xmyoot/custom-round-pcb-led-flash/client_request/IMG_7281.PNG

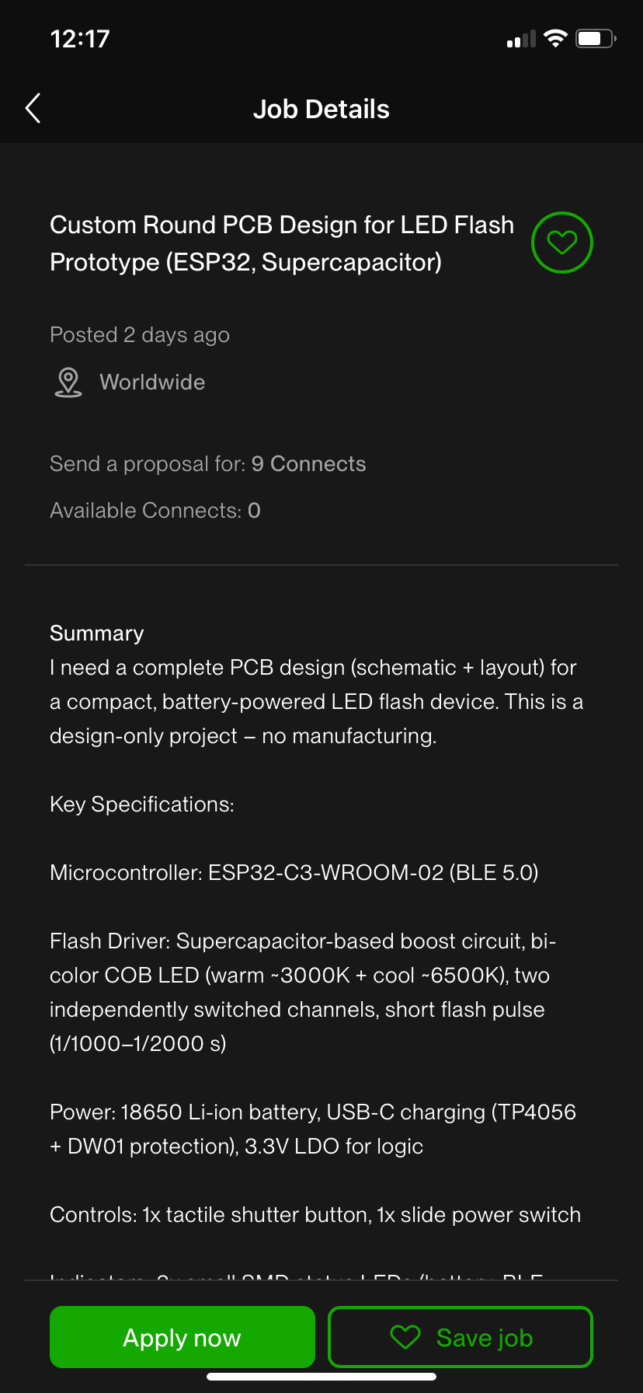
client_request/IMG_7281.PNG
