xmyoot/custom-round-pcb-led-flash/client_request/IMG_7282.PNG

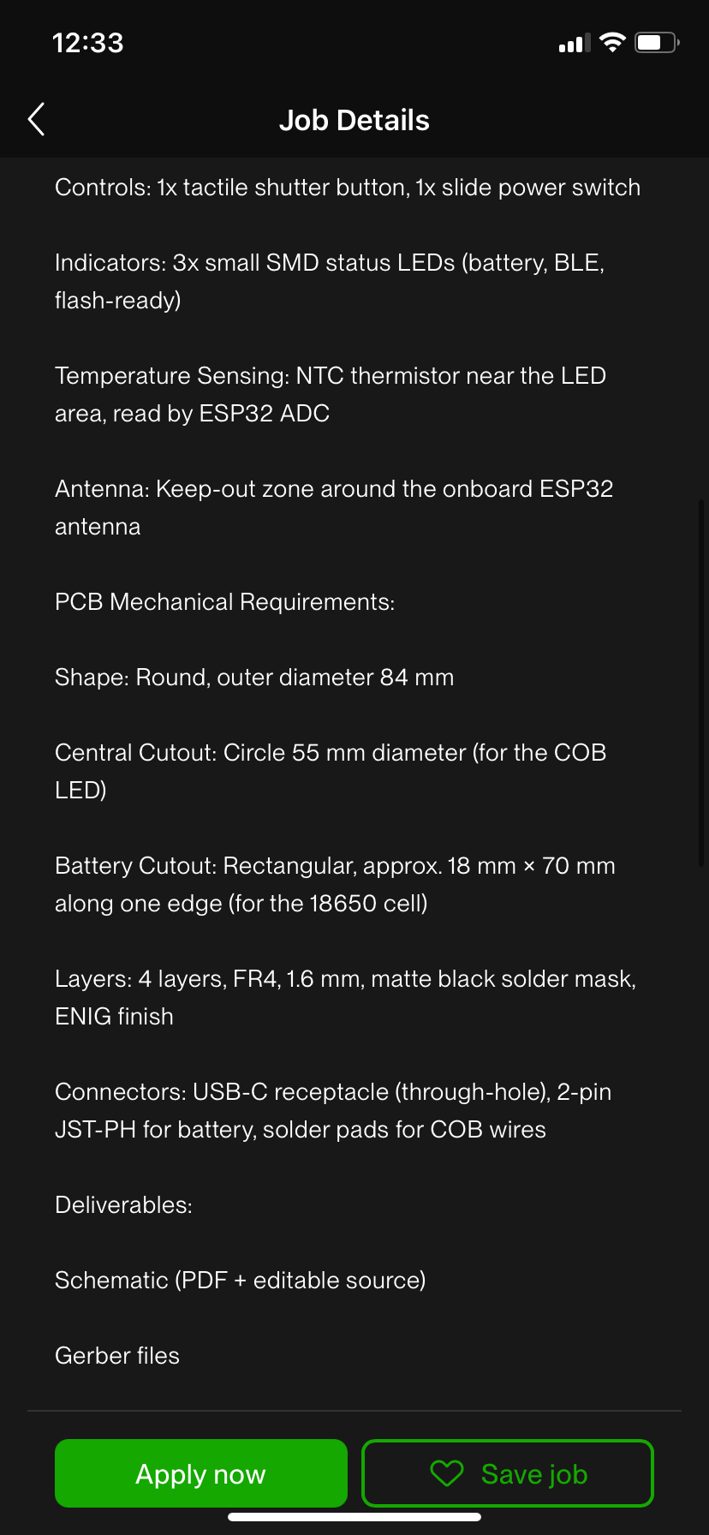
client_request/IMG_7282.PNG
