xmyoot/custom-round-pcb-led-flash/client_request/IMG_7283.PNG

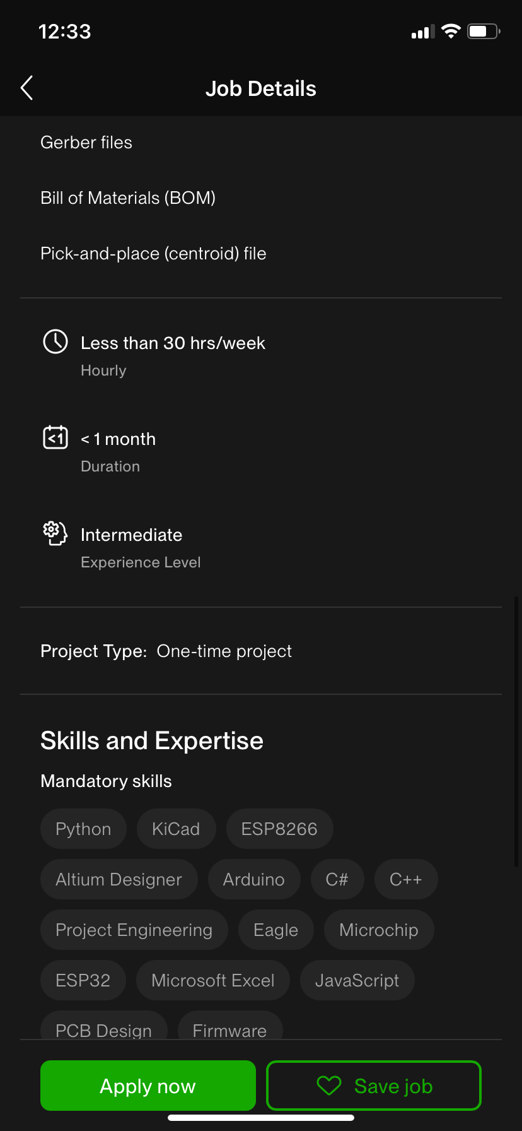
client_request/IMG_7283.PNG
