xmyoot/custom-round-pcb-led-flash/output/renders/Round_LED_Flash_3D_Bottom.png

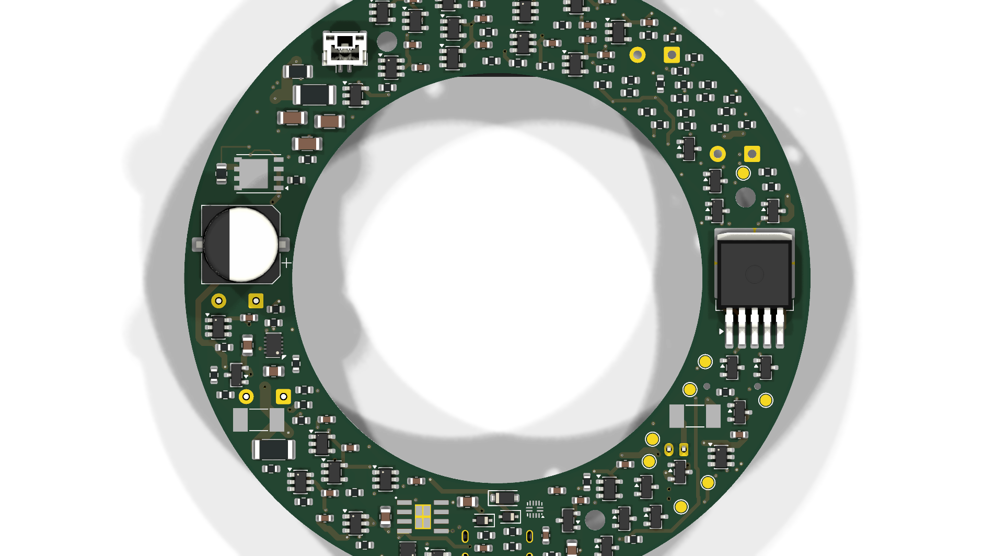
output/renders/Round_LED_Flash_3D_Bottom.png
