xmyoot/custom-round-pcb-led-flash/output/pdf/Round_LED_Flash_Schematic.pdf

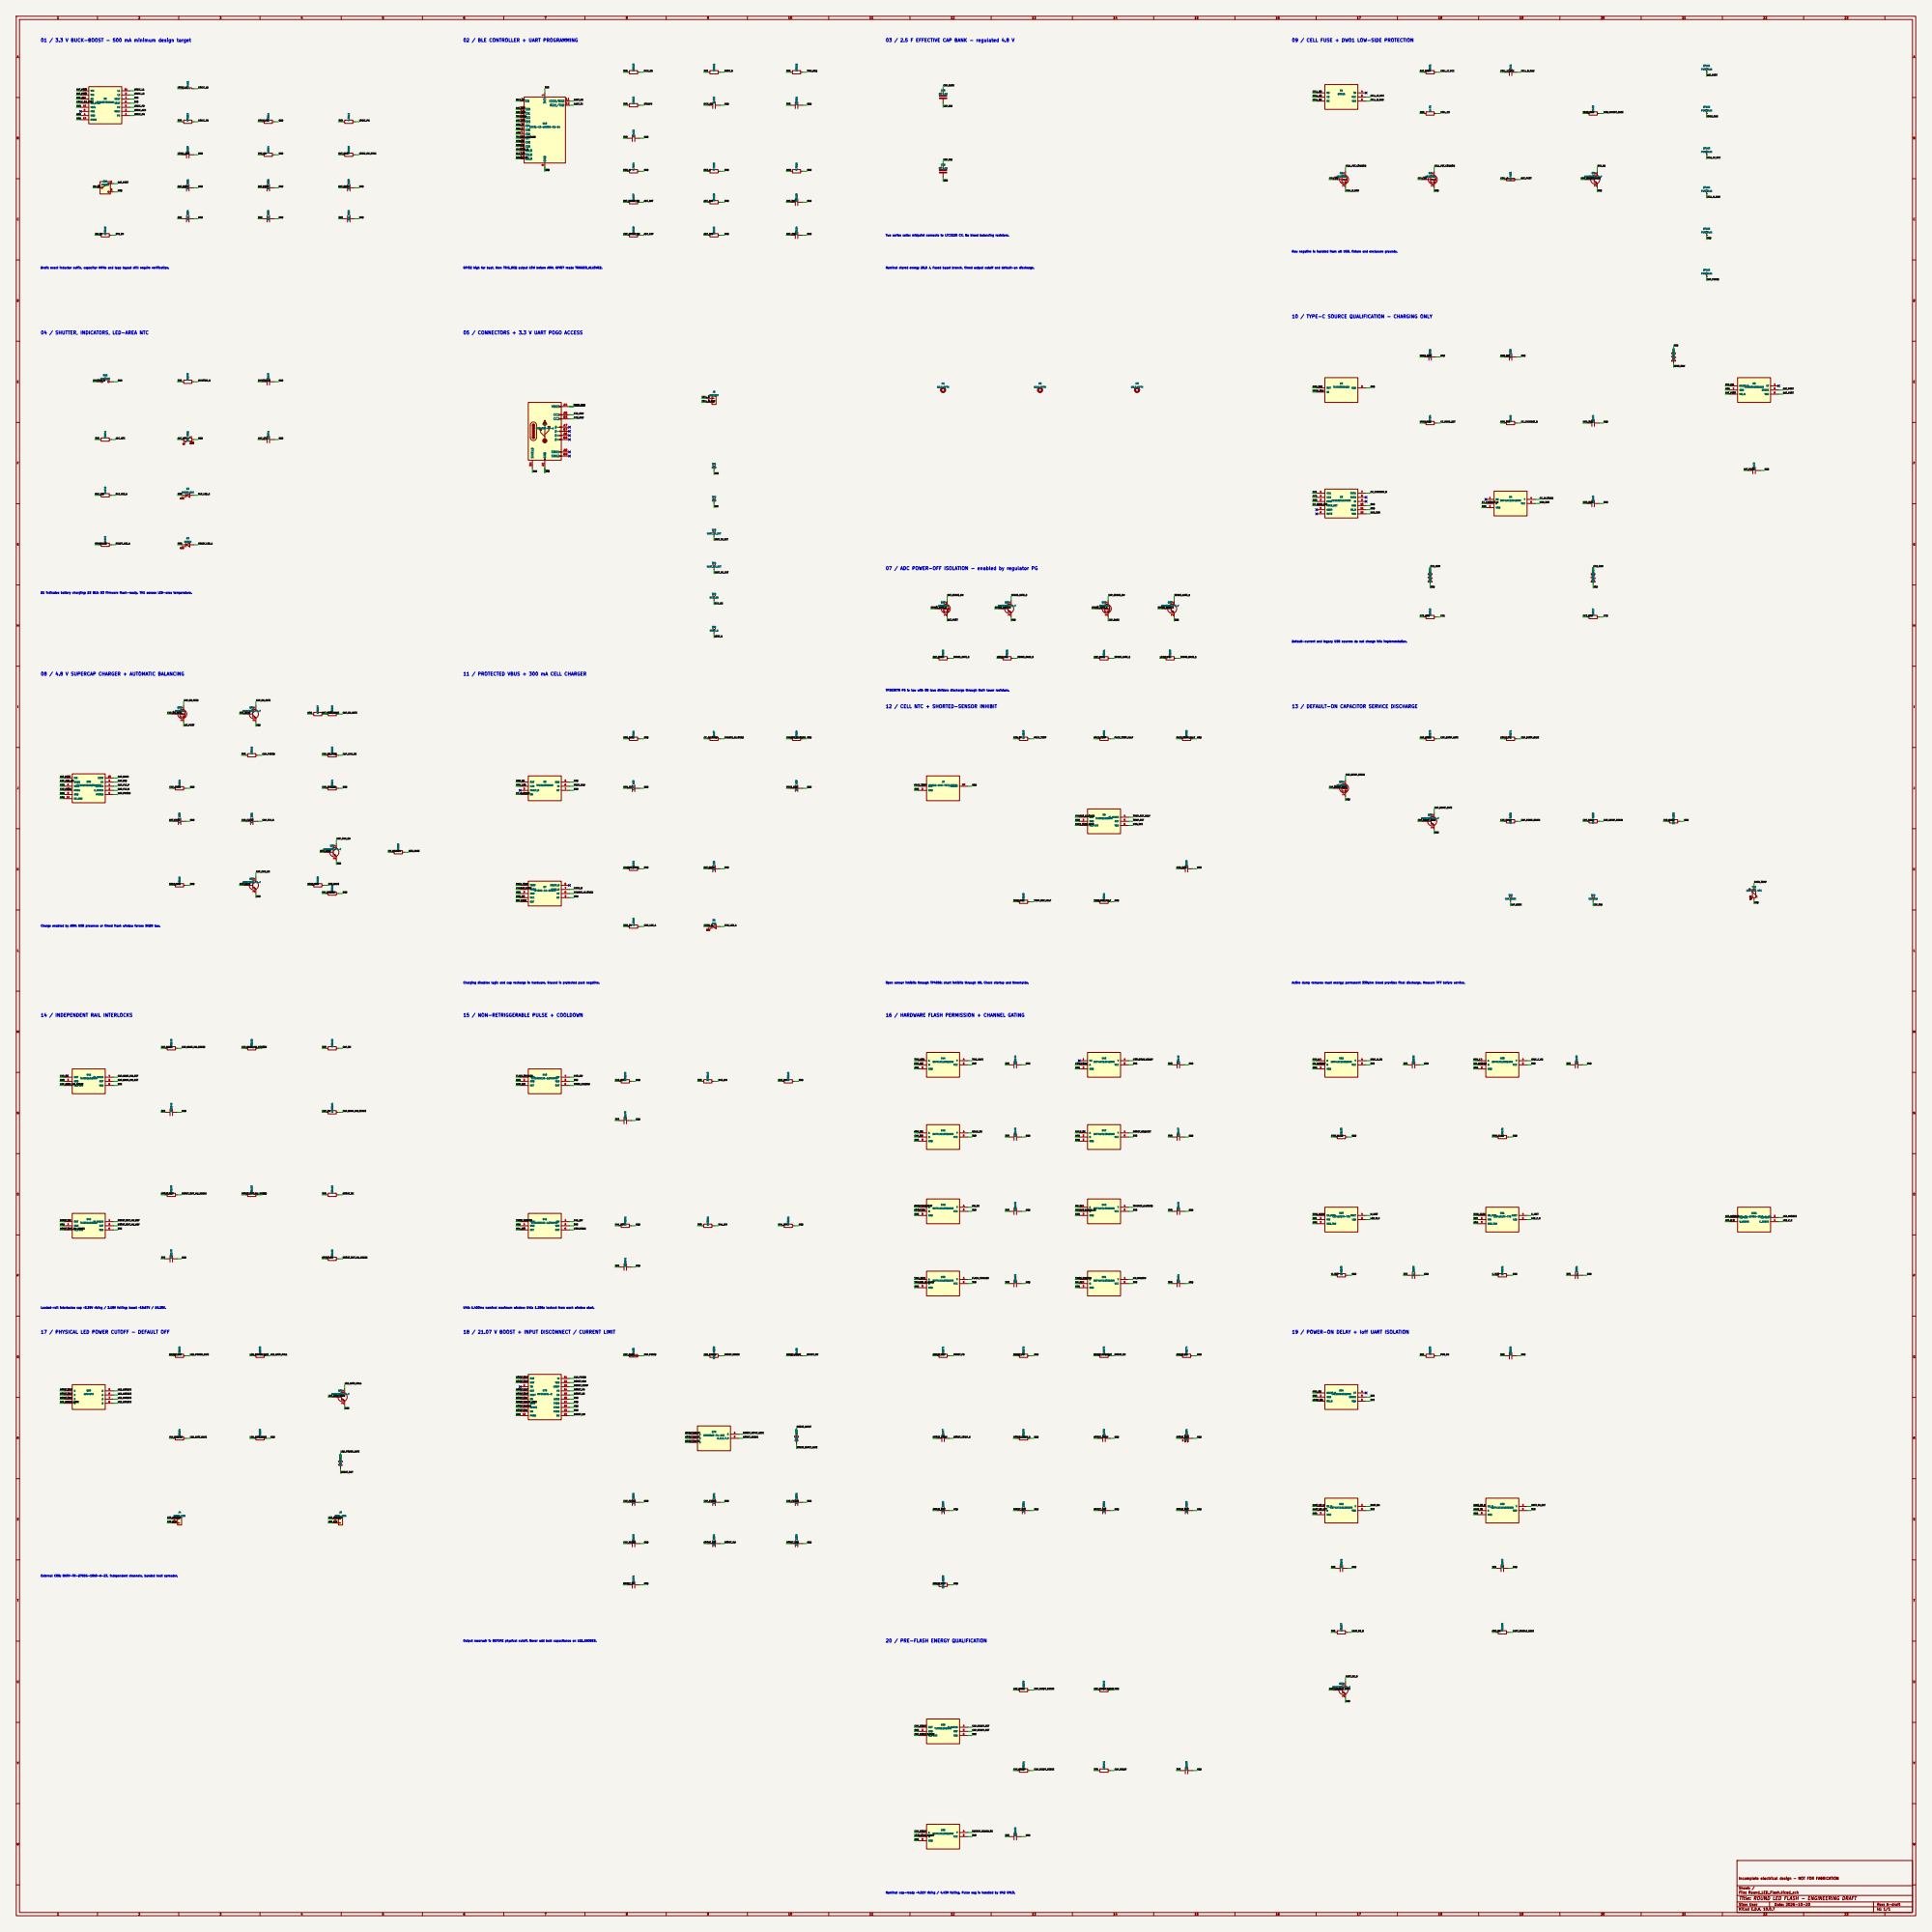
[picture p7: page 1]

01 / 3.3 V BUCK-BOOST - 500 mA minimum design target

02 / BLE CONTROLLER + UART PROGRAMMING

03 / 2.5 F EFFECTIVE CAP BANK - regulated 4.8 V

09 / CELL FUSE + DW01 LOW-SIDE PROTECTION

Two series cells; midpoint connects to LTC3225 CX. No bleed balancing resistors.

Raw negative is isolated from all USB, fixture and enclosure grounds. Nominal stored energy 28.8 J. Fused boost branch, timed output cutoff and default-on discharge.

Draft: exact inductor suffix, capacitor MPNs and loop layout still require verification.

GPIO2 high for boot, then TRIG_REQ output LOW before ARM. GPIO7 reads TRIGGER_ALLOWED.

10 / TYPE-C SOURCE QUALIFICATION - CHARGING ONLY

04 / SHUTTER, INDICATORS, LED-AREA NTC

05 / CONNECTORS + 3.3 V UART POGO ACCESS

07 / ADC POWER-OFF ISOLATION - enabled by regulator PG

D1 indicates battery charging; D2 BLE; D3 firmware flash-ready. TH1 senses LED-area temperature.

Default-current and legacy USB sources do not charge this implementation.

08 / 4.8 V SUPERCAP CHARGER + AUTOMATIC BALANCING

11 / PROTECTED VBUS + 300 mA CELL CHARGER

TPS63070 PG is low with EN low; dividers discharge through their lower resistors.

12 / CELL NTC + SHORTED-SENSOR INHIBIT

13 / DEFAULT-ON CAPACITOR SERVICE DISCHARGE

Charge enabled by ARM; USB presence or timed flash window forces SHDN low.

Charging disables logic and cap recharge in hardware. Ground is protected pack negative.

Open sensor inhibits through TP4056; short inhibits through U8. Check startup and thresholds.

Active dump removes most energy; permanent 330ohm bleed provides final discharge. Measure TP7 before service.

15 / NON-RETRIGGERABLE PULSE + COOLDOWN

16 / HARDWARE FLASH PERMISSION + CHANNEL GATING

Loaded-rail interlocks: cap ~3.39V rising / 3.15V falling; boost ~19.67V / 19.20V.

U40: 1.403ms nominal maximum window; U41: 1.258s lockout from each window start.

17 / PHYSICAL LED POWER CUTOFF - DEFAULT OFF

18 / 21.07 V BOOST + INPUT DISCONNECT / CURRENT LIMIT

19 / POWER-ON DELAY + Ioff UART ISOLATION

External COB: BXRV-TR-2765G-10A0-A-23, independent channels, bonded heat spreader.

Incomplete electrical design - NOT FOR FABRICATION

Sheet: /
File: Round_LED_Flash.kicad_sch
Title: ROUND LED FLASH - ENGINEERING DRAFT

Nominal cap-ready ~4.51V rising / 4.43V falling. Pulse sag is handled by U42 UVLO.

Size: User | Rev: A-draft
KiCad E.D.A. 10.0.7 | Id: 1/1
