xmyoot/custom-round-pcb-led-flash/Round_LED_Flash.kicad_pcb

## KiCad design Round_LED_Flash.kicad_pcb (2026-10-21)

Schematic: Round_LED_Flash.kicad_sch, Round LED Flash — Annular Ring Camera Strobe

Parts:
C1, C4, C5, C9, C10, C21, C23, C24, C40, C41, C80, C140, C141, C142, C143, C144, C145, C146, C147, C148, C149, C150, C151, C152, C153, C155, C156, C162, C163, C236, C273: 100n; C_0603_1608Metric; MPN GRM188R71H104KA93D
C2: 1u 50V; C_0805_2012Metric; MPN GRM21BR71H105KA12L
C3, C230, C231: 1u 10V; C_0603_1608Metric; MPN GRM188R61C105KA12D
C6: 4.7u 16V; C_0805_2012Metric; MPN GRM21BR71E475KA73L
C7, C274, C283: 100n 50V; C_0603_1608Metric; MPN GRM188R71H104KA93D
C8, C11, C12, C13: 10u 10V; C_0805_2012Metric; MPN GRM21BR61C106KE15L
C14, C15, C16: 22u 16V; C_0805_2012Metric; MPN GRM21BR61C226ME44L
C20: 1u; C_0603_1608Metric; MPN GRM188R61C105KA12D
C22: 10u; C_0805_2012Metric; MPN GRM21BR61C106KE15L
C30, C32: 5F 2.7V; CP_Radial_D10.0mm_P5.00mm; MPN HV1020-2R7505-R
C60: 4.7u 10V; C_0805_2012Metric; MPN GRM21BR71E475KA73L
C61: 2.2u 16V; C_0805_2012Metric; MPN GRM21BR71C225KA12L
C270, C271, C272: 22u 10V; C_1206_3216Metric; MPN GRM31CR61C226KE15L
C275: 2.2u 10V; C_0805_2012Metric; MPN GRM21BR71C225KA12L
C276: 10n; C_0603_1608Metric; MPN GRM188R71H103KA01D
C277: 33n; C_0603_1608Metric; MPN GRM188R71H333KA61D
C278: 47p; C_0603_1608Metric; MPN GRM1885C1H470JA01D
C280, C281, C282: 10u 50V; C_1210_3225Metric; MPN GRM32ER71H106KA12L
C284: 120u 35V; CP_Elec_10x12.6; MPN 35SVPF120M
D1: RED; LED_0603_1608Metric; MPN LTST-C190KRKT
D2: AMBER BLE; LED_0603_1608Metric; MPN LTST-C190KFKT
D3: GREEN; LED_0603_1608Metric; MPN LTST-C190KGKT
D4, D5: PESD5V0S1BA; D_SOD-323; MPN PESD5V0S1BA,115
D6: SMF4L6.0A; D_SOD-123F; MPN SMF4L6.0A
D60: 10V ZENER; D_SOD-123; MPN BZT52C10-7-F
D70: GATE CLAMP; D_SOD-123; MPN BAV21W-7-F
F1: 2A FAST; Fuse_Littelfuse-NANO2-451_453; MPN 0451002.MRL
F2: 7A FAST; Fuse_Littelfuse-NANO2-451_453; MPN 0451007.MRL
H1, H2, H3: M2.5 NPTH; MountingHole_2.7mm_M2.5
J1: USB4085-GF-A; USB_C_Receptacle_GCT_USB4085; MPN USB4085-GF-A
J2: BATTERY; JST_PH_B2B-PH-K_1x02_P2.00mm_Vertical; MPN B2B-PH-K-S(LF)(SN)
J3: BM02B-GHS-TBT(LF)(SN); JST_GH_BM02B-GHS-TBT_1x02-1MP_P1.25mm_Vertical; MPN BM02B-GHS-TBT(LF)(SN)
J4: WARM COB; SolderWire-0.5sqmm_1x02_P4.6mm_D0.9mm_OD2.1mm
J5: COOL COB; SolderWire-0.5sqmm_1x02_P4.6mm_D0.9mm_OD2.1mm
L1: 1.5uH; Coilcraft_XFL4020; MPN XFL4020-152MEC
L2: 1.5uH; L_Coilcraft_XAL7030-152; MPN XAL7030-152MEC
LED1: BXRV-TR-2765G-10A0-A-23; MPN BXRV-TR-2765G-10A0-A-23
Q1, Q2, Q34: AO3400A; SOT-23; MPN AO3400A
Q3, Q22, Q23, Q31, Q32, Q33, Q35, Q61, Q62: MMBT3904-7-F; SOT-23; MPN MMBT3904-7-F
Q20, Q21, Q30: AO3401A; SOT-23; MPN AO3401A
Q60: AO4407A; SOIC-8_3.9x4.9mm_P1.27mm; MPN AO4407A
Q70: SiR800DP-T1-GE3; PowerPAK_SO-8_Single; MPN SiR800DP-T1-GE3
R1: 100; R_0603_1608Metric; MPN RC0603FR-07100RL
R2, R42, R43, R273: 1k; R_0603_1608Metric; MPN RC0603FR-071KL
R3, R68, R69: 47k; R_0603_1608Metric; MPN RC0603FR-0747KL
R4: 887k; R_0603_1608Metric; MPN RC0603FR-07887KL
R5, R7, R18, R20, R21, R22, R23, R40, R41, R62, R63, R162, R163, R236, R237, R242: 10k; R_0603_1608Metric; MPN RC0603FR-0710KL
R6, R11: 150k; R_0603_1608Metric; MPN RC0603FR-07150KL
R8, R13, R50, R51, R52, R53, R60, R64, R65, R66, R67, R70, R71, R83, R84, R152, R220, R221, R235, R274: 100k; R_0603_1608Metric; MPN RC0603FR-07100KL
R9: 4.02k; R_0603_1608Metric; MPN RC0603FR-074K02L
R10: 470k; R_0603_1608Metric; MPN RC0603FR-07470KL
R12, R24, R25, R26, R100, R101, R232: 4.7k; R_0603_1608Metric; MPN RC0603FR-074K7L
R14, R81, R82, R165: 1M; R_0603_1608Metric; MPN RC0603FR-071ML
R15, R233, R234: 2.2k; R_0603_1608Metric; MPN RC0603FR-072K2L
R16, R17: 22; R_0603_1608Metric; MPN RC0603FR-0722RL
R27, R28, R29, R30: 22k; R_0603_1608Metric; MPN RC0603FR-0722KL
R61: 24k; R_0603_1608Metric; MPN RC0603FR-0724KL
R72, R73: 100 0.5W; R_2010_5025Metric; MPN RC2010FK-07100RL
R74: 330 0.25W; R_1206_3216Metric; MPN RC1206FR-07330RL
R80: 6.49k; R_0603_1608Metric; MPN RC0603FR-076K49L
R142: 165k; R_0603_1608Metric; MPN RC0603FR-07165KL
R143: 147k; R_0603_1608Metric; MPN TNPW0603147KBEEA
R153, R272: 10k; R_0603_1608Metric; MPN TNPW060310K0BEEA
R164: 2.21M; R_0603_1608Metric; MPN RC0603FR-072M21L
R200: 137k; R_0603_1608Metric; MPN RC0603FR-07137KL
R201: 240k; R_0603_1608Metric; MPN RC0603FR-07240KL
R210: 357k; R_0603_1608Metric; MPN RC0603FR-07357KL
R211: 146k; R_0603_1608Metric; MPN RC0603FR-07146KL
R230, R231: 2.49k; R_0603_1608Metric; MPN RC0603FR-072K49L
R238: 56k; R_0603_1608Metric; MPN RC0603FR-0756KL
R239: 261k; R_0603_1608Metric; MPN TNPW0603261KBEEA
R240: 100k; R_0603_1608Metric; MPN TNPW0603100KBEEA
R241: 10M; R_0603_1608Metric; MPN RC0603FR-0710ML
R270: 0.010 0.5W; R_0805_2012Metric; MPN WSLP0805R0100FEA
R271: 162k; R_0603_1608Metric; MPN TNPW0603162KBEEA
R275: 120k; R_0603_1608Metric; MPN RC0603FR-07120KL
R276: 22k 0.125W; R_0805_2012Metric; MPN RC0805FR-0722KL
SW1: POWER; SW_SPDT_CK_JS102011SAQN; MPN JS102011SAQN
SW2: SHUTTER; SW_SPST_TL3342; MPN TL3342F160QG
TH1: 10k NTC; R_0603_1608Metric; MPN NTCG163JF103FT1
TH2: 10k CELL NTC; MPN B57861S0103F040
TP1: GND; TestPoint_Pad_D1.5mm
TP2: 3V3; TestPoint_Pad_D1.5mm
TP3: UART_TX_EXT; TestPoint_Pad_D1.5mm
TP4: UART_RX_EXT; TestPoint_Pad_D1.5mm
TP5: MCU_EN; TestPoint_Pad_D1.5mm
TP6: BOOT_N; TestPoint_Pad_D1.5mm
TP7: CAP_BANK; TestPoint_Pad_D1.5mm
TP8: CAP_MID; TestPoint_Pad_D1.5mm
U1: DW01A; SOT-23-6; MPN DW01A
U2: TLV76033DBZR; SOT-23; MPN TLV76033DBZR
U3: TUSB320LAIRWBR; Texas_X2QFN-12_1.6x1.6mm_P0.4mm; MPN TUSB320LAIRWBR
U4, U45: SN74LVC1G04DBVR; SOT-23-5; MPN SN74LVC1G04DBVR
U5: TPS25200DRVR; WSON-6-1EP_2x2mm_P0.65mm_EP1x1.6mm; MPN TPS25200DRVR
U6: TPS63070RNMR; TPS63070_RNM0015A; MPN TPS63070RNMR
U7: TP4056-42-ESOP8; TP4056_TopPower_ESOP8; MPN TP4056-42-ESOP8
U8, U42, U43, U55: TLV3011BIDBVR; SOT-23-6; MPN TLV3011BIDBVR
U9, U54: TPS3808G33DBVR; SOT-23-6; MPN TPS3808G33DBVR
U10: ESP32-C3-WROOM-02-N4; ESP32-C3-WROOM-02_NoViaInPad; MPN ESP32-C3-WROOM-02-N4
U30: LTC3225EDDB#TRMPBF; DFN-10-1EP_2x3mm_P0.5mm_EP0.64x2.4mm; MPN LTC3225EDDB#TRMPBF
U40, U41: LTC6993CS6-1#TRMPBF; SOT-23-6; MPN LTC6993CS6-1#TRMPBF
U44, U46, U47, U48, U49, U50, U51, U52, U53, U56: SN74LVC1G08DBVR; SOT-23-5; MPN SN74LVC1G08DBVR
U60, U61: CAT4101TV-T75; TO-263-5_TabPin3; MPN CAT4101TV-T75
U62, U63: SN74LVC1G125DBVR; SOT-23-5; MPN SN74LVC1G125DBVR
U70: MP3435GL-Z; MP3435_QFN20_3x4; MPN MP3435GL-Z

Connections:
/3V3: C14.1, C15.1, C16.1, C21.1, C22.1, C140.1, C141.1, C142.1, C143.1, C144.1, C145.1, C146.1, C147.1, C148.1, C149.1, C150.1, C151.1, C152.1, C153.1, C155.1, C156.1, C162.1, C163.1, C230.1, C231.1, C236.1, R10.1, R12.1, R20.1, R21.1, R22.1, R23.1, R40.1, R41.1, R62.1, R162.1, R163.1, R210.1, R211.1, R236.1, R237.1, R242.1, TP2.1 (1_1), U6.7 (VOUT), U6.8 (VOUT), U10.1 (3V3), U40.5 (VDD), U41.5 (VDD), U42.6 (VDD), U43.6 (VDD), U44.5 (VCC), U45.5 (VCC), U46.5 (VCC), U47.5 (VCC), U48.5 (VCC), U49.5 (VCC), U50.5 (VCC), U51.5 (VCC), U52.5 (VCC), U53.5 (VCC), U54.5 (SENSE), U54.6 (VDD), U55.6 (VDD), U56.5 (VCC), U60.2 (VIN), U61.2 (VIN), U62.5 (VDD), U63.5 (VDD)
/ADC_BAT: C23.1, R27.2, R28.1, U10.18 (IO0)
/ADC_CAP: C24.1, R29.2, R30.1, U10.17 (IO1)
/ADC_NTC: C41.1, R41.2, TH1.1, U10.15 (IO3)
/ARM: R26.1, R67.1, U10.5 (IO6), U47.2 (B)
/BAT_PROT: C8.1, C9.1, C11.1, C12.1, C13.1, C60.1, F1.2, Q20.2 (S), Q30.2 (S), R1.1, R18.1, R50.1, R60.1, SW1.1 (A), U6.12 (VIN), U6.13 (VIN), U7.5 (BAT), U9.3 (MR_N), U9.5 (SENSE), U9.6 (VDD), U30.9 (VIN)
/BAT_SENSE_SW: Q20.3 (D), R27.1
/BLE_LED: R42.1, U10.13 (IO18)
/BLE_LED_A: D2.2 (A), R42.2
/BOOST_BST: C274.1, U70.4 (BST)
/BOOST_COMP: C277.1, C278.1, U70.13 (COMP)
/BOOST_COMP_R: C277.2, R275.1
/BOOST_EN: R273.2, R274.1, U70.6 (EN)
/BOOST_FB: R271.2, R272.1, U70.14 (FB)
/BOOST_INPUT: D70.2 (A), L2.1, Q70.1 (S), Q70.2 (S), Q70.3 (S)
/BOOST_INPUT_GATE: D70.1 (K), Q70.4 (G), U70.7 (GATE)
/BOOST_OK: R163.2, R165.1, U43.1 (OUT), U48.2 (B)
/BOOST_OUT: C280.1, C281.1, C282.1, C283.1, C284.1, D60.1 (K), Q60.1 (S), Q60.2 (S), Q60.3 (S), R143.1, R232.1, R271.1, R276.1, U70.1 (OUT), U70.2 (OUT), U70.5 (SOUT)
/BOOST_OUT_HW_REF: U43.4 (IN_MINUS), U43.5 (REF)
/BOOST_OUT_HW_SENSE: R143.2, R153.1, R165.2, U43.3 (IN_PLUS)
/BOOST_REQUEST: R273.1, U47.4 (Y), U48.1 (A)
/BOOST_SENSE: Q70.5 (D_5_6_7_8), R270.2, U70.8 (SENSE)
/BOOST_SS: C276.1, U70.15 (SS)
/BOOST_SW: C274.2, L2.2, U70.9 (SW), U70.20 (SW)
/BOOST_VDD: C275.1, U70.12 (VDD)
/BOOT_N: R21.2, TP6.1 (1_1), U10.8 (IO9)
/CAP_BANK: C30.1, F2.1, Q21.2 (S), R51.1, R70.1, R72.1, R73.1, R74.1, R142.1, R239.1, TP7.1 (1_1), U30.10 (COUT)
/CAP_BANK_HW_REF: U42.4 (IN_MINUS), U42.5 (REF)
/CAP_BANK_HW_SENSE: R142.2, R152.1, R164.2, U42.3 (IN_PLUS)
/CAP_CHG_EN: Q32.3 (C), Q33.3 (C), R63.2, R64.1, U30.4 (SHDN)
/CAP_DUMP_BASE: Q35.1 (B), R71.2
/CAP_DUMP_DRAIN: Q34.3 (D), R72.2, R73.2
/CAP_DUMP_GATE: Q34.1 (G), Q35.3 (C), R70.2
/CAP_EN_FEED: Q30.3 (D), R63.1
/CAP_EN_GATE: Q30.1 (G), Q31.3 (C), R60.2
/CAP_FLY_N: C61.2, U30.2 (C_MINUS)
/CAP_FLY_P: C61.1, U30.1 (C_PLUS)
/CAP_FUSED: C270.1, C271.1, C272.1, C273.1, F2.2, R270.1, U70.11 (IN)
/CAP_MID: C30.2, C32.1, TP8.1 (1_1), U30.3 (CX)
/CAP_OK: R162.2, R164.1, U42.1 (OUT), U46.2 (B)
/CAP_PGOOD: R62.2, U30.5 (PGOOD)
/CAP_PROG: R61.1, U30.7 (PROG)
/CAP_READY: R241.1, R242.2, U55.1 (OUT), U56.1 (A)
/CAP_READY_REF: U55.4 (IN_MINUS), U55.5 (REF)
/CAP_READY_SENSE: R239.2, R240.1, R241.2, U55.3 (IN_PLUS)
/CAP_SENSE_SW: Q21.3 (D), R29.1
/CC1: R16.2, U3.1 (CC1)
/CC1_RAW: D4.2 (A2), J1.A5 (CC1), R16.1
/CC2: R17.2, U3.2 (CC2)
/CC2_RAW: D5.2 (A2), J1.B5 (CC2), R17.1
/CC_ALLOWED: R7.1, U4.4 (Y), U5.4 (EN)
/CC_CURRENT_N: R5.2, U3.7 (OUT1), U4.2 (A)
/CC_VBUS_DET: R4.2, U3.4 (VBUS_DET)
/CELL_CS: R2.2, U1.2 (CS)
/CELL_FET_COMMON: Q1.3 (D), Q2.3 (D)
/CELL_IC_VCC: C1.1, R1.2, U1.5 (VCC)
/CELL_N_RAW: C1.2, J2.2, Q1.2 (S), U1.6 (VSS)
/CELL_OC: Q2.1 (G), U1.3 (OC)
/CELL_OD: Q1.1 (G), U1.1 (OD)
/CELL_P: F1.1, J2.1
/CHARGE_ALLOWED: R7.2, R8.1, U7.8 (CE), U8.1 (OUT)
/CHARGE_PROG: R9.1, U7.2 (PROG)
/CHG_LED_A: D1.2 (A), R15.2
/CHRG_N: D1.1 (K), U7.7 (CHRG_N)
/COOLDOWN: U41.6 (OUT), U45.2 (A)
/COOLDOWN_READY: U45.4 (Y), U56.2 (B)
/C_ISET: R231.1, U61.4 (RSET)
/ENERGY_REARM_OK: U49.2 (B), U56.4 (Y)
/FLASH_TRIGGER: U40.1 (TRIG), U50.4 (Y)
/GND: C2.2, C3.2, C4.2, C5.2, C6.2, C7.2, C8.2, C9.2, C10.2, C11.2, C12.2, C13.2, C14.2, C15.2, C16.2, C20.2, C21.2, C22.2, C23.2, C24.2, C32.2, C40.2, C41.2, C60.2, C80.2, C140.2, C141.2, C142.2, C143.2, C144.2, C145.2, C146.2, C147.2, C148.2, C149.2, C150.2, C151.2, C152.2, C153.2, C155.2, C156.2, C162.2, C163.2, C230.2, C231.2, C236.2, C270.2, C271.2, C272.2, C273.2, C275.2, C276.2, C278.2, C280.2, C281.2, C282.2, C283.2, C284.2, D2.1 (K), D3.1 (K), D4.1 (A1), D5.1 (A1), D6.2 (A2), J1.A1 (GND), J1.A12 (GND), J1.B1 (GND), J1.B12 (GND), J1.SH (SHIELD), J3.2 (GND), J3.MP (MOUNT), Q2.2 (S), Q3.2 (E), Q22.2 (E), Q23.2 (E), Q31.2 (E), Q32.2 (E), Q33.2 (E), Q34.2 (S), Q35.2 (E), Q61.2 (E), Q62.2 (E), R2.1, R6.2, R8.2, R9.2, R11.2, R14.2, R24.2, R25.2, R26.2, R28.2, R30.2, R61.2, R64.2, R65.2, R66.2, R74.2, R82.2, R84.2, R100.2, R101.2, R152.2, R153.2, R200.2, R201.2, R220.2, R221.2, R230.2, R231.2, R235.2, R240.2, R272.2, R274.2, R275.2, R276.2, SW1.3 (C), SW2.2, TH1.2, TH2.2, TP1.1 (1_1), U2.3 (GND), U3.3 (PORT), U3.10 (GND), U3.11 (EN_N), U4.3 (GND), U5.5 (GND), U5.7 (EP), U6.4 (GND), U6.10 (PGND), U6.15 (VSEL), U7.3 (GND), U7.9 (EP), U8.2 (GND), U9.2 (GND), U10.9 (GND), U10.19 (GND), U30.6 (VSEL), U30.8 (GND), U30.11 (EP_GND), U40.2 (GND), U41.2 (GND), U42.2 (GND), U43.2 (GND), U44.3 (GND), U45.3 (GND), U46.3 (GND), U47.3 (GND), U48.3 (GND), U49.3 (GND), U50.3 (GND), U51.3 (GND), U52.3 (GND), U53.3 (GND), U54.2 (GND), U55.2 (GND), U56.3 (GND), U60.3 (GND_TAB), U61.3 (GND_TAB), U62.3 (GND), U63.3 (GND), U70.10 (PGND), U70.16 (AGND), U70.17 (PGND), U70.18 (PGND), U70.19 (PGND)
/HW_OK: U48.4 (Y), U49.1 (A), U51.2 (B)
/HW_WINDOW: R66.1, R68.1, R234.1, U51.4 (Y), U52.2 (B), U53.2 (B)
/LED_ANODES: J4.1, J5.1, LED1.1 (W_PLUS), LED1.3 (C_PLUS), Q60.5 (D), Q60.6 (D), Q60.7 (D), Q60.8 (D)
/LED_C_K: J5.2, LED1.4 (C_MINUS), U61.5 (LED)
/LED_GATE_BASE: Q61.1 (B), R234.2, R235.1
/LED_GATE_PULL: Q61.3 (C), R233.2
/LED_POWER_GATE: D60.2 (A), Q60.4 (G), R232.2, R233.1
/LED_W_K: J4.2, LED1.2 (W_MINUS), U60.5 (LED)
/LOGIC_AUX: C10.1, U6.3 (VAUX)
/LOGIC_FB: R10.2, R11.1, U6.5 (FB)
/LOGIC_L1: L1.1, U6.11 (L1)
/LOGIC_L2: L1.2, U6.9 (L2)
/LOGIC_PG: R12.2, R52.1, R53.1, R71.1, U6.2 (PG), U54.3 (MR_N)
/LOGIC_PS_SYNC: R18.2, U6.1 (PS_SYNC)
/MCU_EN: C20.1, R20.2, TP5.1 (1_1), U10.2 (EN)
/PACK_TEMP: J3.1 (NTC), R80.2, R81.1, TH2.1, U7.1 (TEMP)
/PACK_TEMP_HALF: R81.2, R82.1, U8.3 (IN_PLUS)
/POR_OK: R236.2, R238.1, U44.2 (B), U46.1 (A), U54.1 (RESET_N)
/Q31_BASE: Q31.1 (B), R67.2
/Q32_BASE: Q32.1 (B), R68.2
/Q33_BASE: Q33.1 (B), R69.2
/RAILS_OK: U46.4 (Y), U47.1 (A)
/READY_LED: R43.1, U10.14 (IO19)
/READY_LED_A: D3.2 (A), R43.2
/REQ_C: R25.1, U10.4 (IO5), U53.1 (A)
/REQ_W: R24.1, U10.3 (IO4), U52.1 (A)
/SENSE_BASE_0: Q22.1 (B), R52.2
/SENSE_BASE_1: Q23.1 (B), R53.2
/SENSE_GATE_0: Q20.1 (G), Q22.3 (C), R50.2
/SENSE_GATE_1: Q21.1 (G), Q23.3 (C), R51.2
/SHUTTER_N: C40.1, R40.2, SW2.1, U10.10 (IO10)
/SINK_C_EN: R101.1, U53.4 (Y), U61.1 (EN_PWM)
/SINK_W_EN: R100.1, U52.4 (Y), U60.1 (EN_PWM)
/STRAP8: R23.2, U10.7 (IO8)
/SW_ON: R13.1, SW1.2 (B)
/SYS_EN: Q3.3 (C), R13.2, R14.1, U6.14 (EN), U9.1 (RESET_N)
/TEMP_REF: R83.1, U8.5 (REF)
/TEMP_REF_HALF: R83.2, R84.1, U8.4 (IN_MINUS)
/TIMER_WINDOW: U40.6 (OUT), U41.1 (TRIG), U51.1 (A)
/TRIGGER_ALLOWED: U10.6 (IO7), U49.4 (Y), U50.2 (B)
/TRIG_REQ: R22.2, U10.16 (IO2), U44.1 (A)
/TRIG_SAFE: U44.4 (Y), U50.1 (A)
/U40_DIV: R210.2, R220.1, U40.4 (DIV)
/U40_SET: R200.1, U40.3 (SET)
/U41_DIV: R211.2, R221.1, U41.4 (DIV)
/U41_SET: R201.1, U41.3 (SET)
/UART_ENABLE_BASE: Q62.1 (B), R238.2
/UART_OE_N: Q62.3 (C), R237.2, U62.1 (OE_N), U63.1 (OE_N)
/UART_RX: U10.11 (IO20/RXD), U62.4 (Y)
/UART_RX_EXT: TP4.1 (1_1), U62.2 (A)
/UART_TX: U10.12 (IO21/TXD), U63.2 (A)
/UART_TX_EXT: TP3.1 (1_1), U63.4 (Y)
/USB_3V3: C3.1, C4.1, C5.1, C80.1, R5.1, U2.1 (OUT), U3.12 (VDD), U4.5 (VCC), U8.6 (VDD)
/USB_5V: C6.1, R15.1, R80.1, U5.1 (OUT), U7.4 (VCC)
/USB_ILIM: R6.1, U5.2 (ILIM)
/USB_INHIBIT_BASE: Q3.1 (B), R3.2
/VBUS_RAW: C2.1, C7.1, D6.1 (A1), J1.A4 (VBUS), J1.A9 (VBUS), J1.B4 (VBUS), J1.B9 (VBUS), R3.1, R4.1, R65.1, R69.1, U2.2 (IN), U5.6 (IN)
/W_ISET: R230.1, U60.4 (RSET)

Notes on the sheet:
01 / 3.3 V BUCK-BOOST - 500 mA minimum design target
Draft: exact inductor suffix, capacitor MPNs and loop layout still require verification.
02 / BLE CONTROLLER + UART PROGRAMMING
GPIO2 high for boot, then TRIG_REQ output LOW before ARM. GPIO7 reads TRIGGER_ALLOWED.
03 / 2.5 F EFFECTIVE CAP BANK - regulated 4.8 V
Two series cells; midpoint connects to LTC3225 CX. No bleed balancing resistors.
Nominal stored energy 28.8 J. Fused boost branch, timed output cutoff and default-on discharge.
04 / SHUTTER, INDICATORS, LED-AREA NTC
D1 indicates battery charging; D2 BLE; D3 firmware flash-ready. TH1 senses LED-area temperature.
05 / CONNECTORS + 3.3 V UART POGO ACCESS
07 / ADC POWER-OFF ISOLATION - enabled by regulator PG
TPS63070 PG is low with EN low; dividers discharge through their lower resistors.
08 / 4.8 V SUPERCAP CHARGER + AUTOMATIC BALANCING
Charge enabled by ARM; USB presence or timed flash window forces SHDN low.
09 / CELL FUSE + DW01 LOW-SIDE PROTECTION
Raw negative is isolated from all USB, fixture and enclosure grounds.
10 / TYPE-C SOURCE QUALIFICATION - CHARGING ONLY
Default-current and legacy USB sources do not charge this implementation.
11 / PROTECTED VBUS + 300 mA CELL CHARGER
Charging disables logic and cap recharge in hardware. Ground is protected pack negative.
12 / CELL NTC + SHORTED-SENSOR INHIBIT
Open sensor inhibits through TP4056; short inhibits through U8. Check startup and thresholds.
13 / DEFAULT-ON CAPACITOR SERVICE DISCHARGE
Active dump removes most energy; permanent 330ohm bleed provides final discharge. Measure TP7 before service.
14 / INDEPENDENT RAIL INTERLOCKS
Loaded-rail interlocks: cap ~3.39V rising / 3.15V falling; boost ~19.67V / 19.20V.
15 / NON-RETRIGGERABLE PULSE + COOLDOWN
U40: 1.403ms nominal maximum window; U41: 1.258s lockout from each window start.
16 / HARDWARE FLASH PERMISSION + CHANNEL GATING
17 / PHYSICAL LED POWER CUTOFF - DEFAULT OFF
External COB: BXRV-TR-2765G-10A0-A-23, independent channels, bonded heat spreader.
19 / POWER-ON DELAY + Ioff UART ISOLATION
20 / PRE-FLASH ENERGY QUALIFICATION
Nominal cap-ready ~4.51V rising / 4.43V falling. Pulse sag is handled by U42 UVLO.
18 / 21.07 V BOOST + INPUT DISCONNECT / CURRENT LIMIT
Output reservoir is BEFORE physical cutoff. Never add bulk capacitance on LED_ANODES.

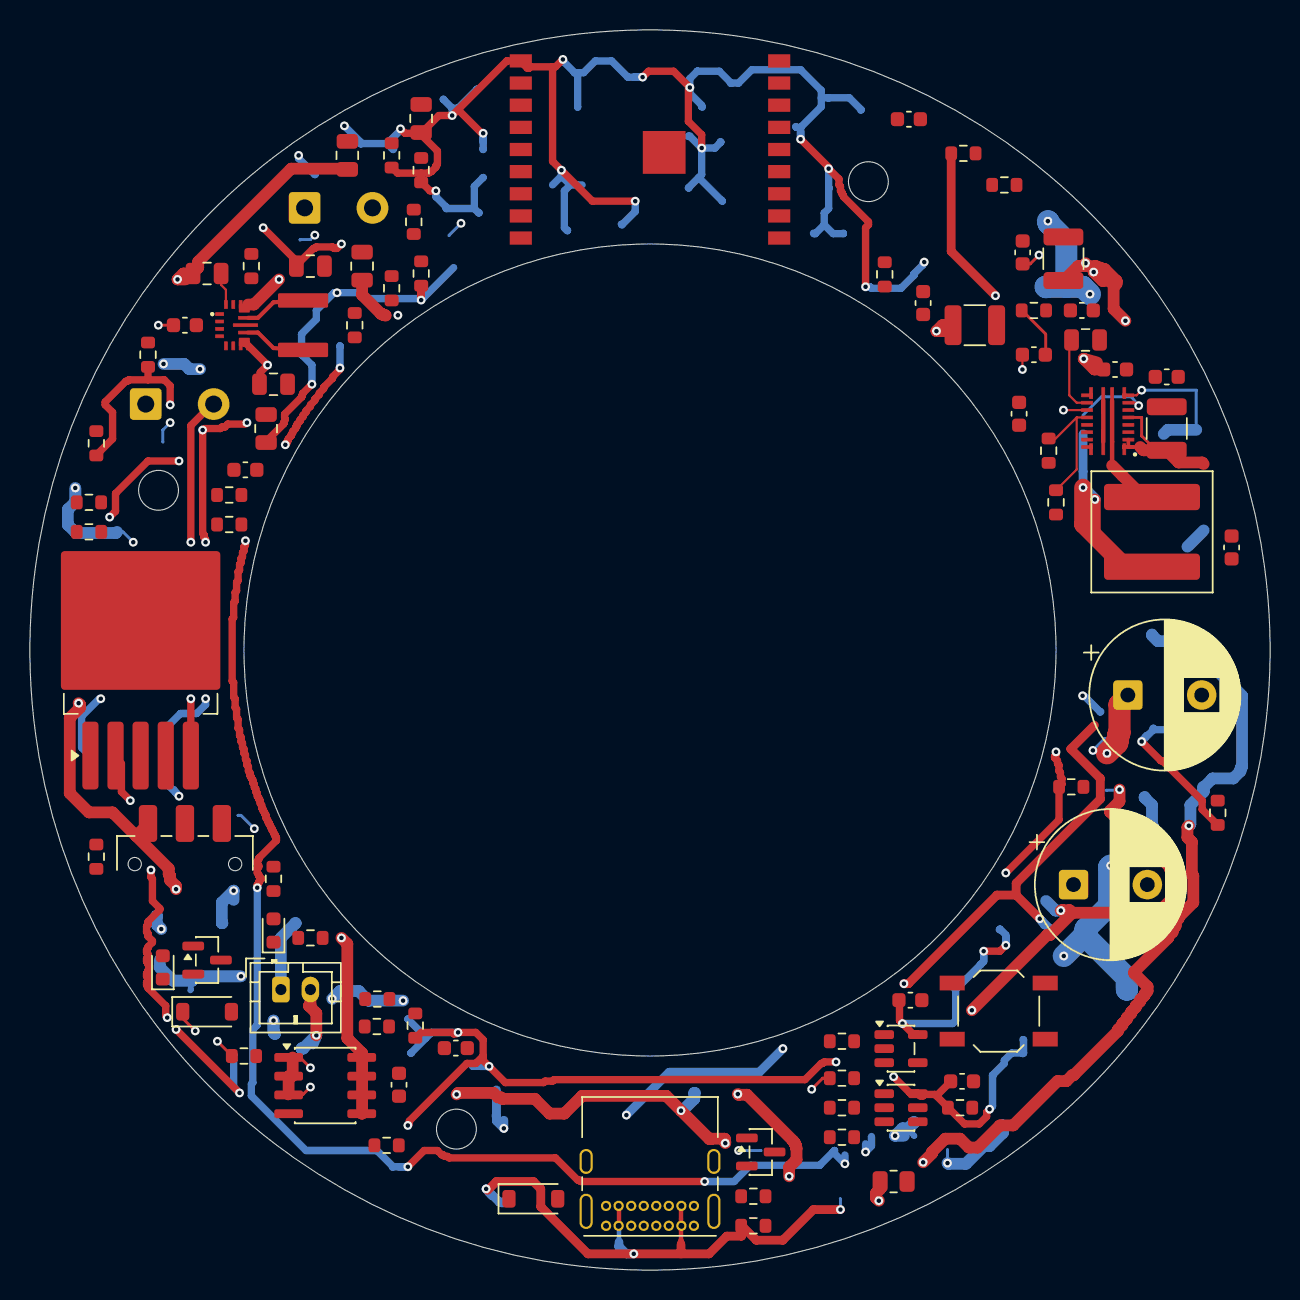
[picture p8: board Round_LED_Flash.kicad_pcb from above]

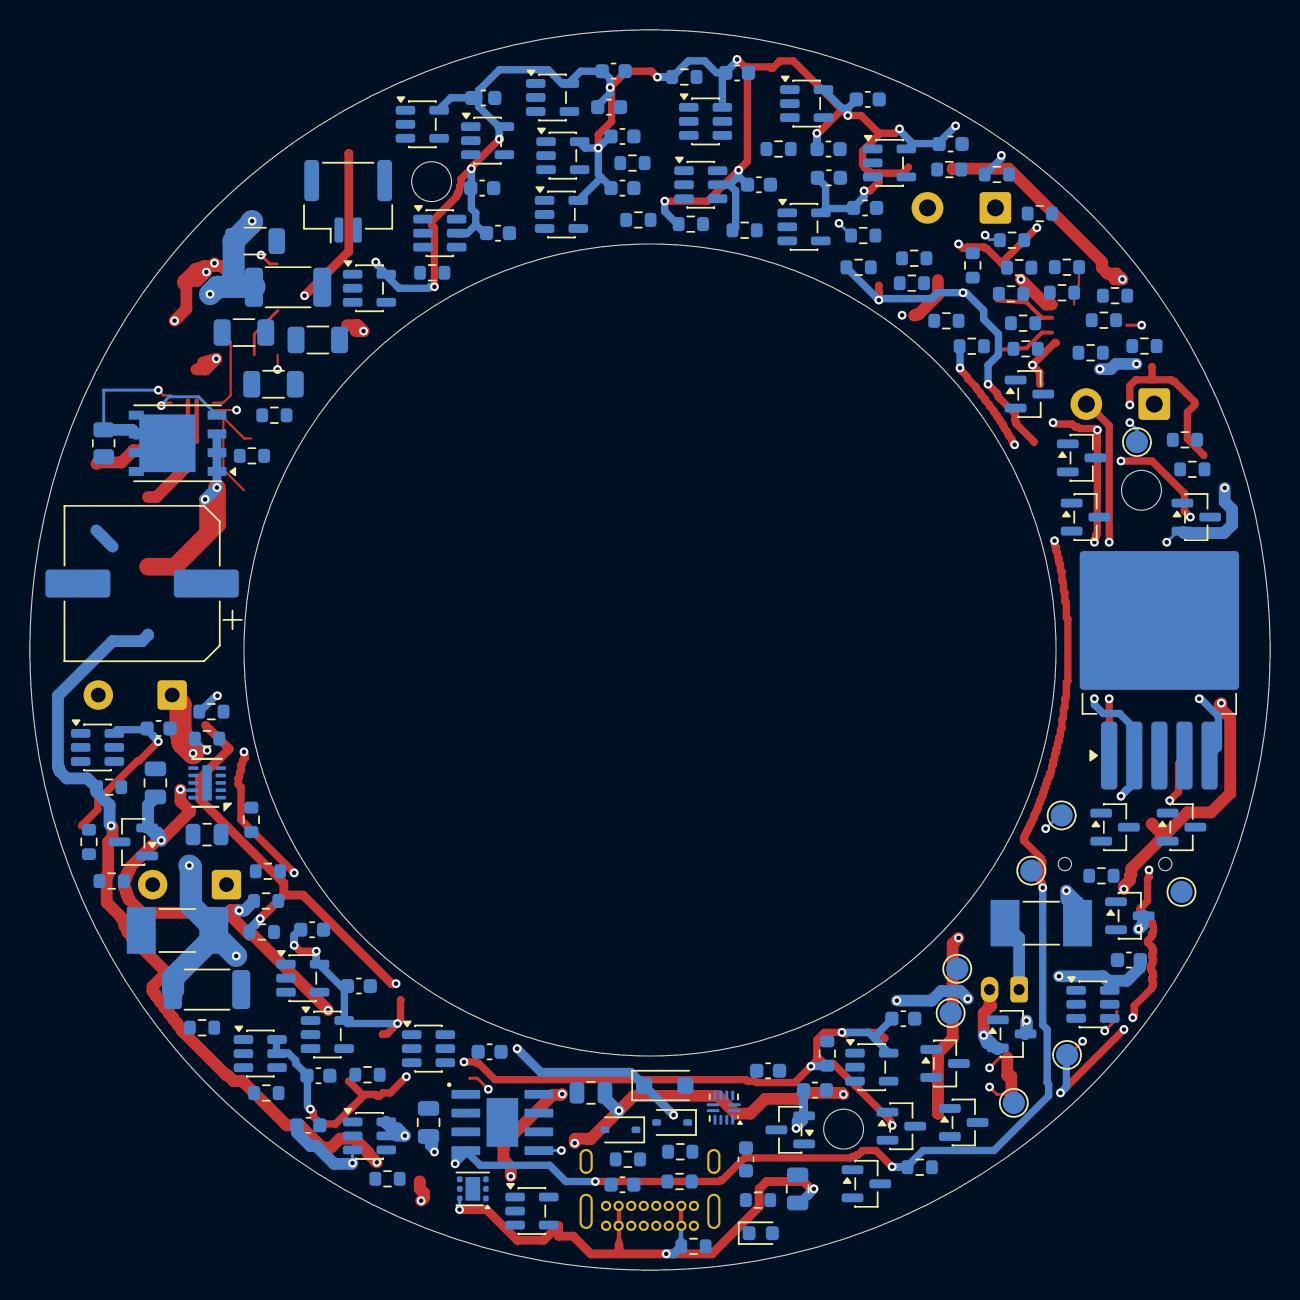
[picture p9: board Round_LED_Flash.kicad_pcb from below]

Board: 4 copper layers, 84.0 x 84.0 mm, 237 parts (148 on the bottom side), 128 nets.
