xmyoot/custom-round-pcb-led-flash/(commit log)

2026-10-21 Create KiCad 10 controller and mechanical engineering core
    [Round_LED_Flash.kicad_pcb, Round_LED_Flash.kicad_sch, bom.csv]
2026-10-21 Preserve balanced supercapacitor charger draft before completion
    [Round_LED_Flash.kicad_pcb, Round_LED_Flash.kicad_sch, bom.csv]
2026-10-21 Complete prototype circuit candidate with protected power and bounded flash control
    [Round_LED_Flash.kicad_pcb, Round_LED_Flash.kicad_sch, bom.csv]
2026-10-21 Correct service bleed and ADC leakage; refine converter and decoupling placement
    [Round_LED_Flash.kicad_pcb, Round_LED_Flash.kicad_sch]
2026-10-21 Update Round LED Flash schematic, layout, routing scripts, and documentation
    [Round_LED_Flash.kicad_pcb, Round_LED_Flash.kicad_sch, bom.csv]
2026-10-21 Update title blocks to Rev A prototype candidate, add comprehensive design review, and enhance README
    [Round_LED_Flash.kicad_pcb, Round_LED_Flash.kicad_sch]
2026-10-21 Add KiCad 10 3D raytraced renders to README and output directory
